jihoonkim413/water-quality-monitor/hardware/water_carrier/render_top.png

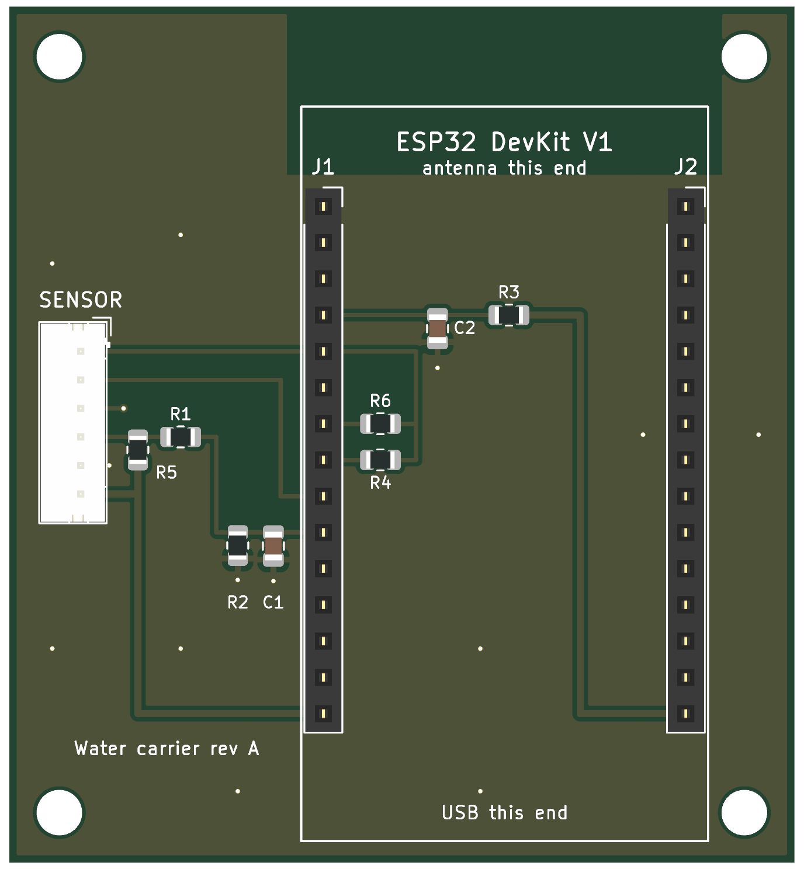
hardware/water_carrier/render_top.png
