jihoonkim413/water-quality-monitor/hardware/water_carrier/jlcpcb/bom.csv

Comment | Designator | Footprint | LCSC Part #
1nF | C1 | C_0805_2012Metric | C46653
100nF | C2 | C_0805_2012Metric | C49678
10k | R1,R3 | R_0805_2012Metric | C17414
20k | R2 | R_0805_2012Metric | C4328
4.7k | R4,R5 | R_0805_2012Metric | C17673
47k | R6 | R_0805_2012Metric | C17713
