jihoonkim413/water-quality-monitor/hardware/case/base.stl

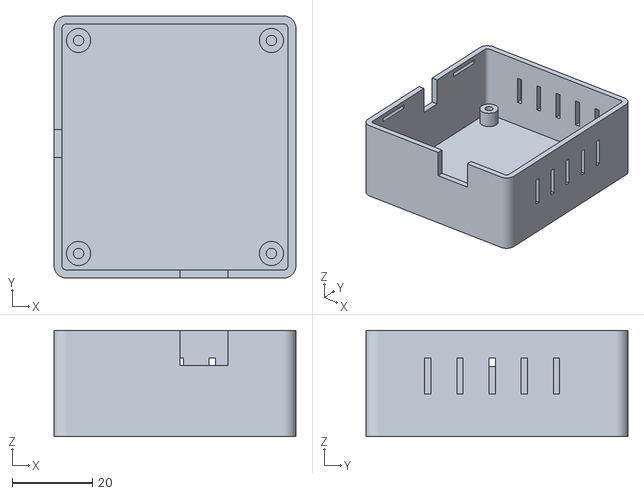
[picture p2: CAD file, 2026-10-22]
hardware/case/base.stl
60.2 x 65.2 x 26.4
