jihoonkim413/water-quality-monitor/hardware/case/lid.stl

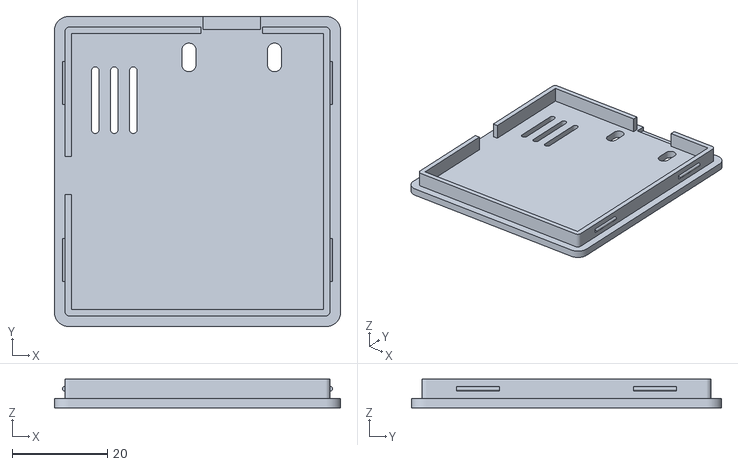
[picture p3: CAD file, 2026-10-22]
hardware/case/lid.stl
60.2 x 65.2 x 6.00
