jihoonkim413/water-quality-monitor/hardware/case/water_case.FCStd

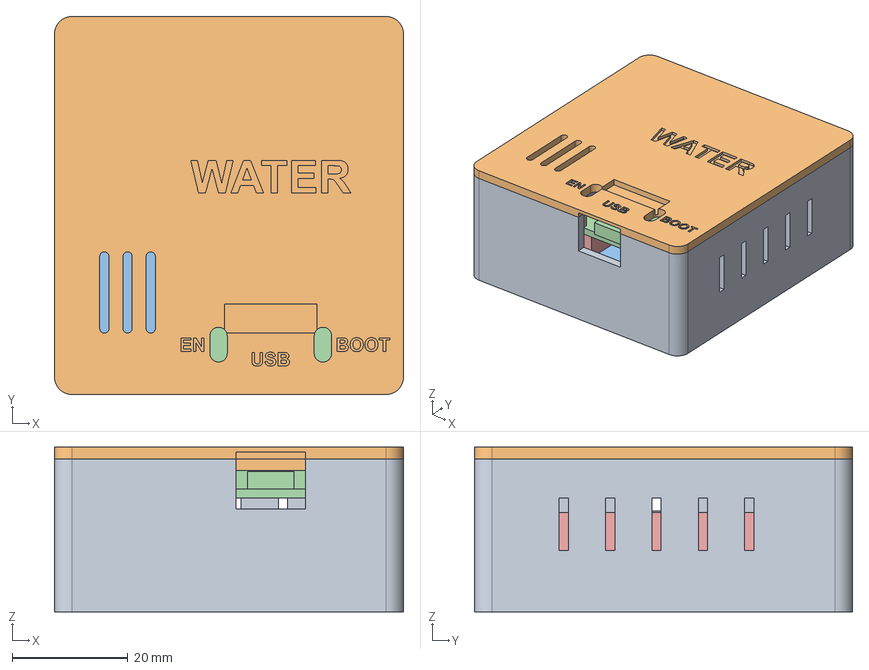
[picture p4: CAD file, 2026-10-22]
hardware/case/water_case.FCStd
60.2 x 65.2 x 28.4 mm
Base
Lid
RefBoard
RefDevKit
RefSockets
RefJST
