jihoonkim413/water-quality-monitor/(list of files, cad)

Other CAD files:
hardware/case/water_case.3mf
