jihoonkim413/water-quality-monitor/hardware/water_carrier/water_carrier_schematic.pdf

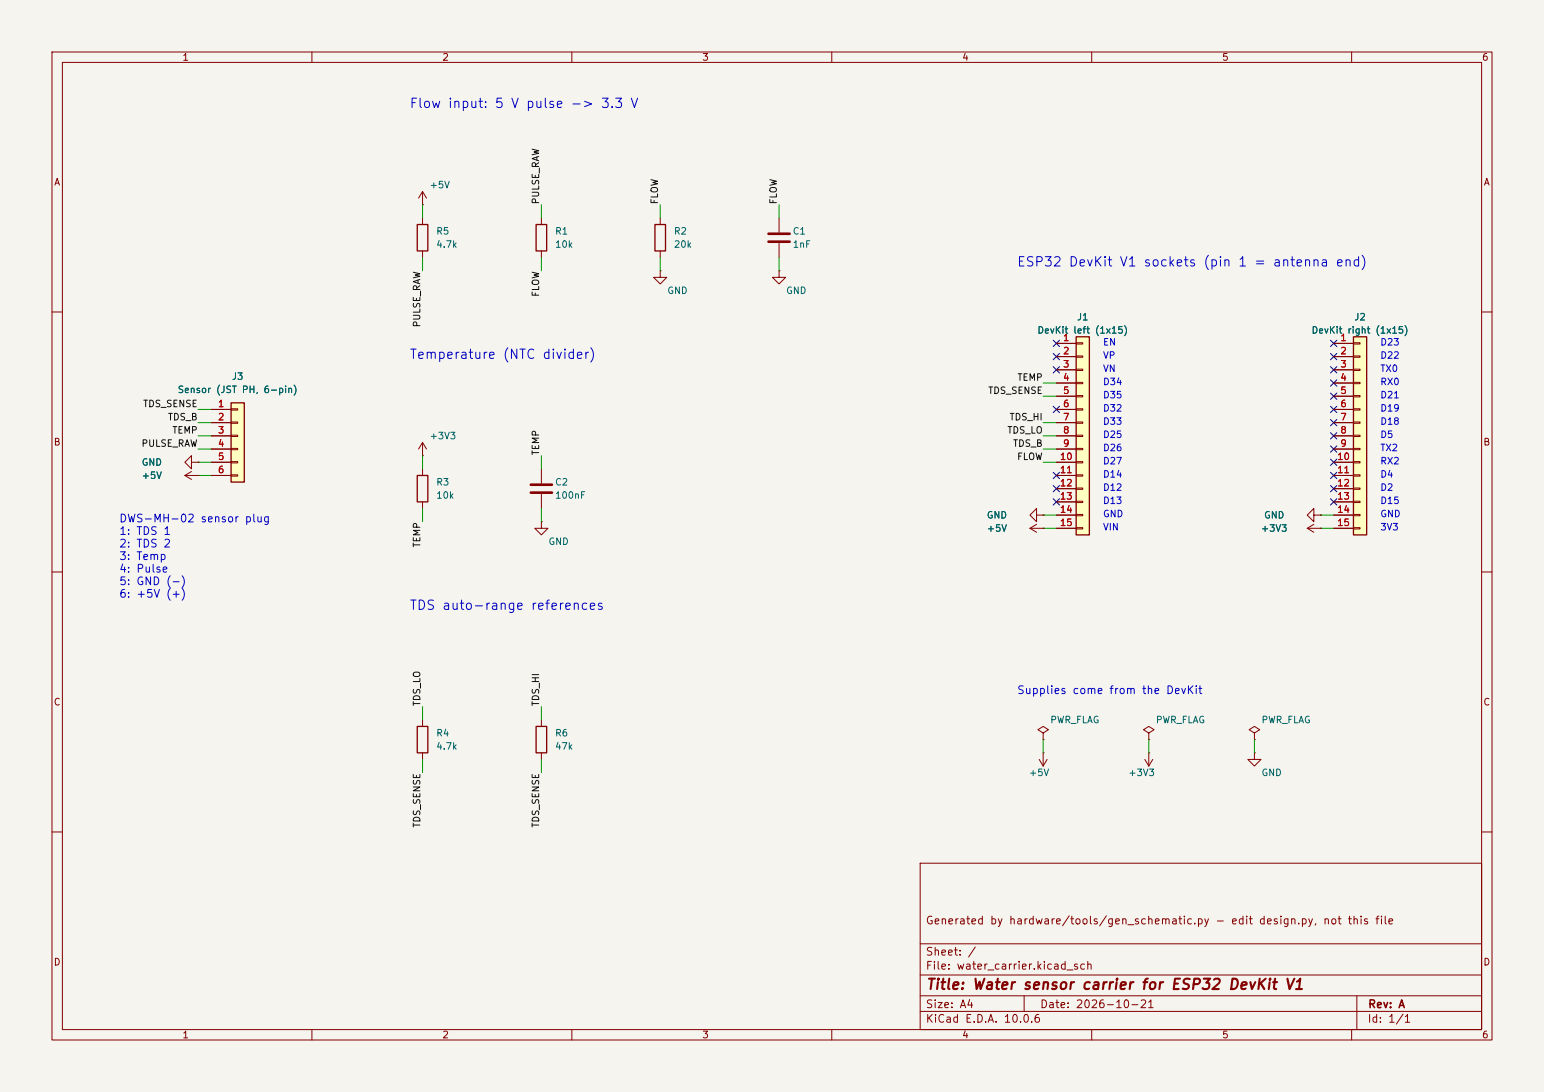
[picture p5: page 1]

D33 D32 D35 D34 ESP32 DevKit V1 sockets (pin 1 = antenna end)

EN TDS auto-range references

Sensor (JST PH, 6-pin) 1

Generated by hardware/tools/gen_schematic.py - edit design.py, not this file

Sheet: /
File: water_carrier.kicad_sch
Title: Water sensor carrier for ESP32 DevKit V1

Size: A4 | Rev: A
KiCad E.D.A. 10.0.6 | Id: 1/1
