jihoonkim413/water-quality-monitor/hardware/water_carrier/water_carrier.kicad_pcb

## KiCad design hardware/water_carrier/water_carrier.kicad_pcb (2026-10-22)

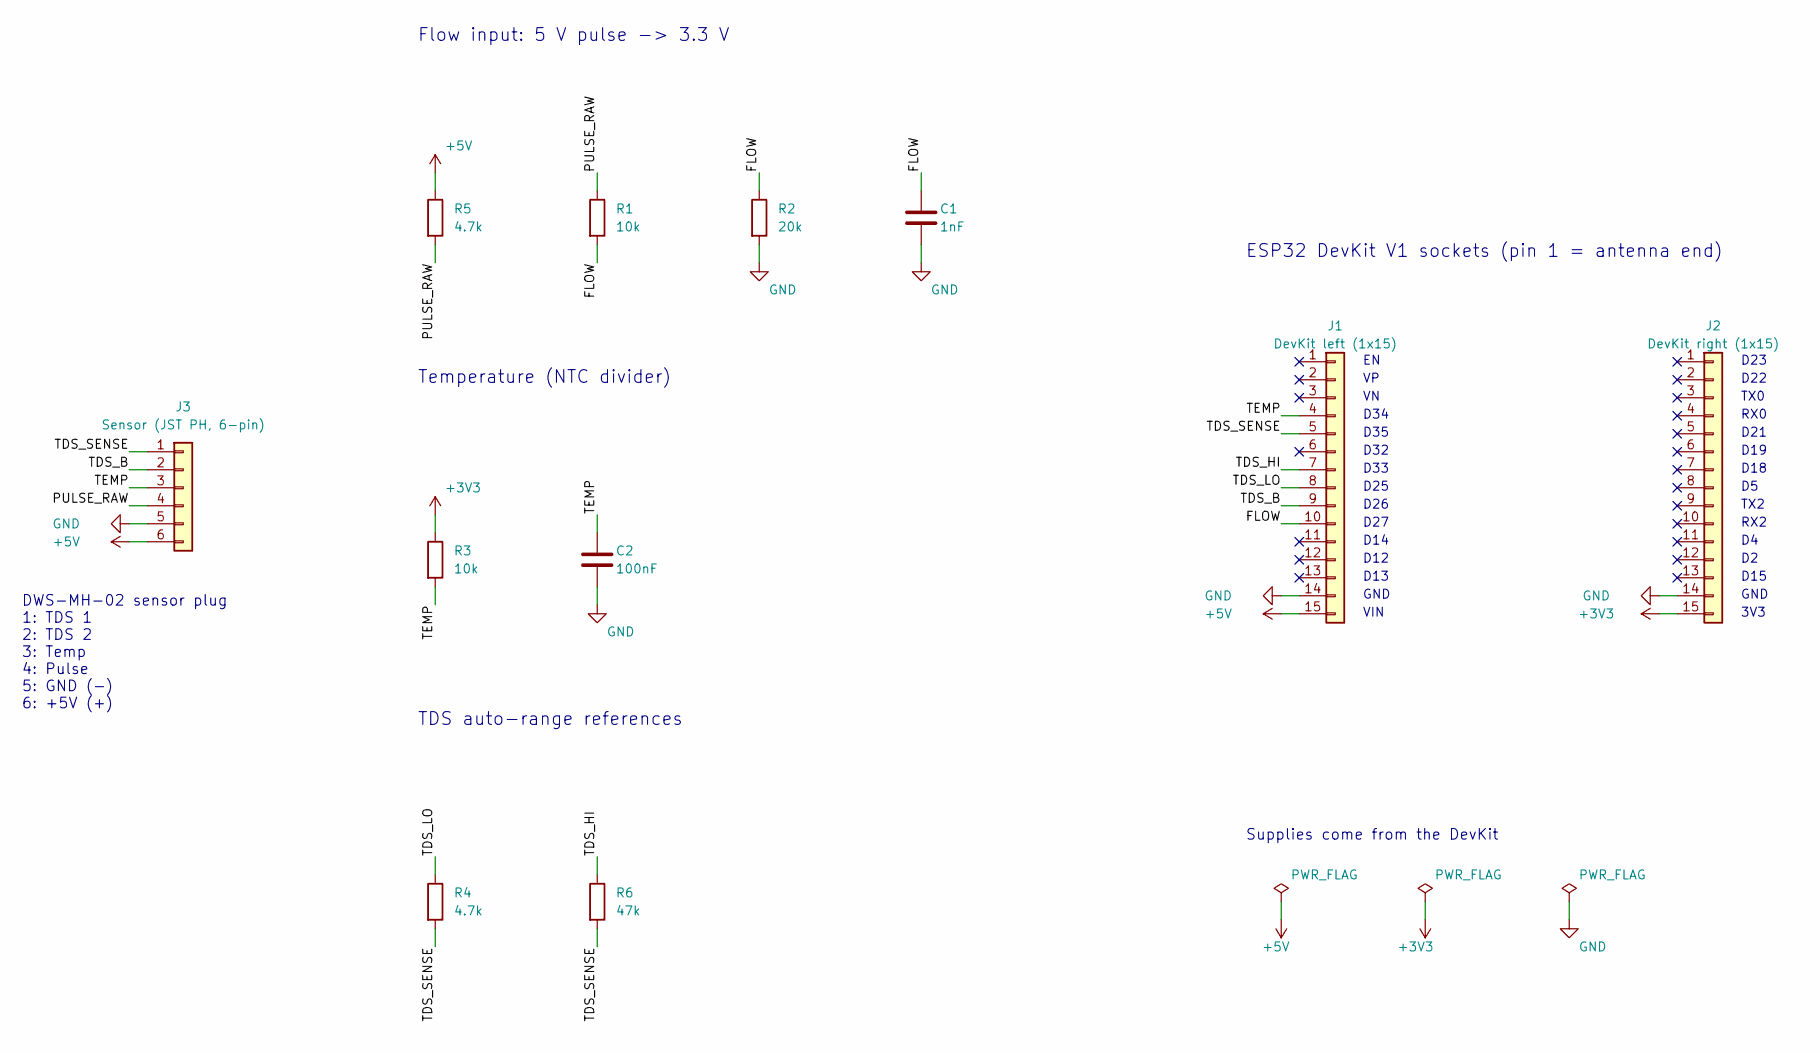
[picture p6: schematic water_carrier.kicad_sch, Water sensor carrier for ESP32 DevKit V1]

Parts:
C1: 1nF; C_0805_2012Metric; LCSC C46653
C2: 100nF; C_0805_2012Metric; LCSC C49678
J1: DevKit left (1x15); PinSocket_1x15_P2.54mm_Vertical
J2: DevKit right (1x15); PinSocket_1x15_P2.54mm_Vertical
J3: Sensor (JST PH, 6-pin); JST_PH_B6B-PH-K_1x06_P2.00mm_Vertical
R1, R3: 10k; R_0805_2012Metric; LCSC C17414
R2: 20k; R_0805_2012Metric; LCSC C4328
R4, R5: 4.7k; R_0805_2012Metric; LCSC C17673
R6: 47k; R_0805_2012Metric; LCSC C17713

Connections:
+3V3: J2.15, R3.1
+5V: J1.15, J3.6, R5.1
/FLOW: C1.1, J1.10, R1.2, R2.1
/PULSE_RAW: J3.4, R1.1, R5.2
/TDS_B: J1.9, J3.2
/TDS_HI: J1.7, R6.1
/TDS_LO: J1.8, R4.1
/TDS_SENSE: J1.5, J3.1, R4.2, R6.2
/TEMP: C2.1, J1.4, J3.3, R3.2
GND: C1.2, C2.2, J1.14, J2.14, J3.5, R2.2

Notes on the sheet:
DWS-MH-02 sensor plug 1: TDS 1 2: TDS 2 3: Temp 4: Pulse 5: GND (-) 6: +5V (+)
D34
D35
D32
D33
D25
D26
D27
D14
D12
D13
GND
VIN
D23
D22
TX0
RX0
D21
D19
D18
TX2
RX2
D15
3V3
ESP32 DevKit V1 sockets (pin 1 = antenna end)
Flow input: 5 V pulse -> 3.3 V
Temperature (NTC divider)
TDS auto-range references
Supplies come from the DevKit

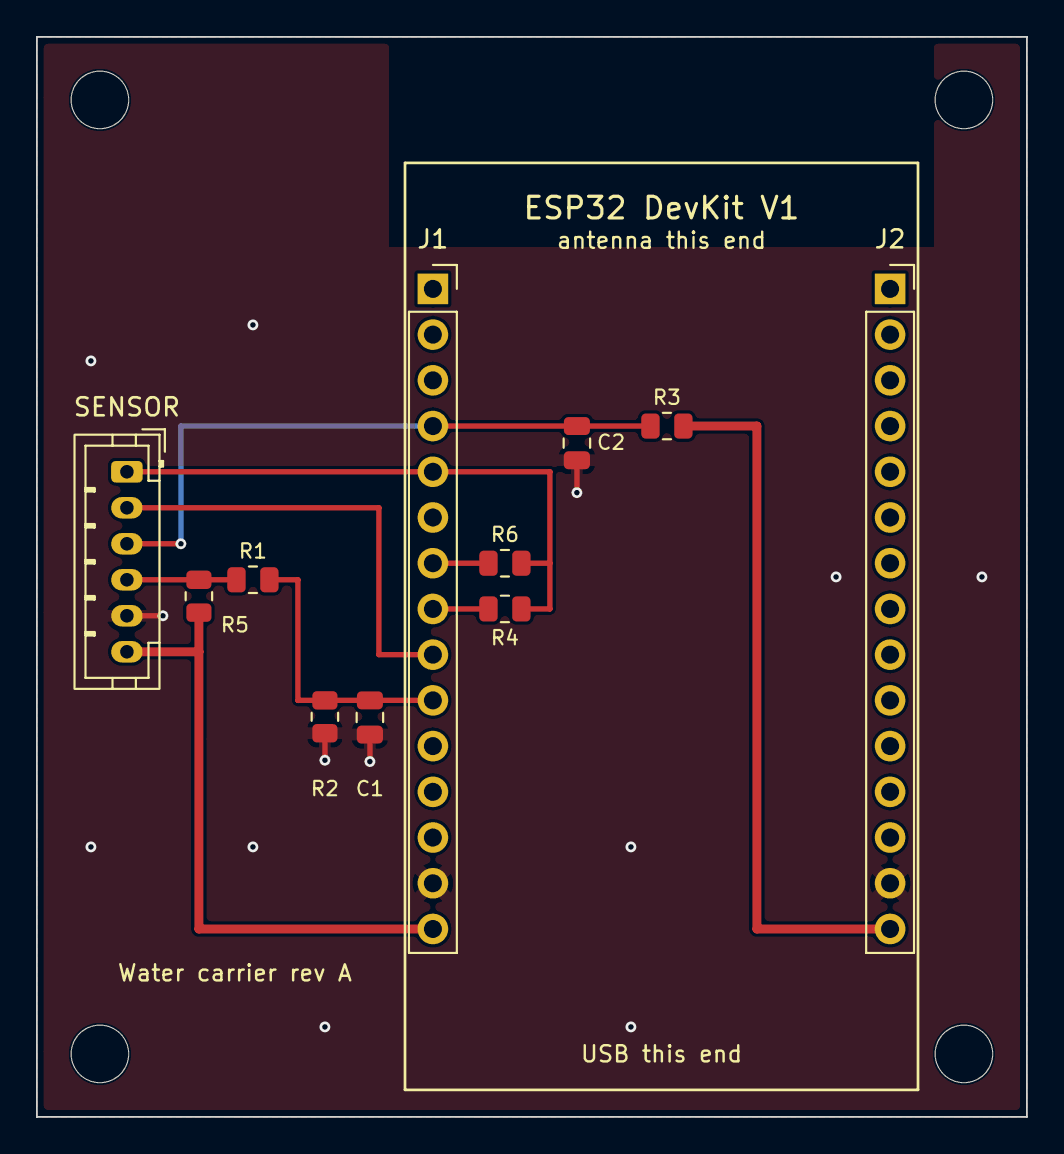
[picture p7: board water_carrier.kicad_pcb from above]

Board: 2 copper layers, 55.0 x 60.0 mm, 15 parts (0 on the bottom side), 10 nets.

Other parts of the board:
H1, H2, H3, H4: M3; MountingHole_3.2mm_M3
