jihoonkim413/water-quality-monitor/(commit log)

2026-10-22 Water quality monitor: firmware, server, carrier PCB and case
    - firmware/: ESP32 DevKit V1 code reading flow, temperature and TDS
    (auto-ranging 4.7k/47k reference), posting to the home server
    - server/: FastAPI + SQLite storage, read API and live dashboard
    - hardware/: generated KiCad schematic and 2-layer carrier PCB
    (design.py is the source of truth), plus FreeCAD snap-fit case
    [base.stl, lid.stl, water_carrier.kicad_pcb, water_carrier.kicad_sch, water_case.FCStd]
2026-10-22 Add JLCPCB order package and print-ready case files
    - hardware/tools/export_jlc.py builds gerber zip, BOM and CPL in
    JLCPCB's format (SMD parts only; sockets are hand-soldered)
    - jlcpcb/: files as submitted for the first board order
    - Case: lid exported upside down for printing, plus a 3MF with both
    parts on one plate for Bambu Studio
    [base.stl, bom.csv, lid.stl, water_case.3mf, water_case.FCStd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]
2026-10-22 Enlarge case USB opening
    - Case: USB opening now 12 x 9.9 mm centred on the socket, with a notch
    in the lid's front edge, so plug bodies up to ~9.5 mm tall seat fully
    - docs/blog: write-up of the project with schematic, PCB and case images
    [base.stl, lid.stl, water_case.3mf, water_case.FCStd]
2026-10-22 Add firmware updates over WiFi (ArduinoOTA)
    - ArduinoOTA with password, started once WiFi is up
    - new 'ota' PlatformIO env; device address and password in local.ini (ignored)
    - min_spiffs partitions: 1.9 MB app slots so updates keep fitting
2026-10-23 Run the server on a Synology NAS with Docker
    - Dockerfile + docker-compose.yml for a Container Manager project;
    readings live in a mounted data/ folder, API key comes from .env
    - app.py starts itself (python app.py), keeps water.db next to the app
    by default, and on the dev PC reads the API key from secrets.h
    - Pin fastapi/uvicorn versions; ignore .env, data/ and the NAS bundle
2026-10-23 Add Android app (Kotlin + Jetpack Compose)
    - Now: current TDS, temperature and flow with 1 h / 24 h / 7 d charts
    - Usage: liters per local day for 7 or 30 days
    - Settings: server address and Cloudflare Access service token
    (build-time defaults from git-ignored secrets.properties)
    - Background alerts every ~15 min for high TDS (hourly average) and a
    silent sensor, each notifying once until it clears; off by default
2026-11-02 Fix temperature: DWS-MH-02 thermistor is 50k, not 10k
    Status now also prints the raw thermistor pin voltage for diagnosis.
    [main.cpp]
2026-11-02 TDS: fix tap water reading low (two-point fit with probe series resistance)
    - 10 us half-cycles: 100 us let the electrodes polarize in salty water
    - resistance from the forward/reverse ratio, independent of supply and ADC gain
    - new 'rs' setting removes the probe's ~750 ohm series resistance; fits
    filtered (11.5), 50/50 (335) and tap (582 ppm) within 2.5%
    - remove temporary scan command
    [main.cpp]
2026-11-04 Add WiFi console for commands; block calibration on bad temperature
    Commands (status, tds, rs, flowstart/flowstop, ppl) now also work over
    WiFi on port 23 (nc <DEVICE_ID>.local 23, OTA_PASS as the first line),
    so the sensor can be calibrated in place without USB.
    tds refuses to calibrate when the temperature is missing or outside
    1-45 C, since the temperature at calibration is baked into cellK.
    [main.cpp]
